nchlswhttkr/fit1041/images/buttons.jpg

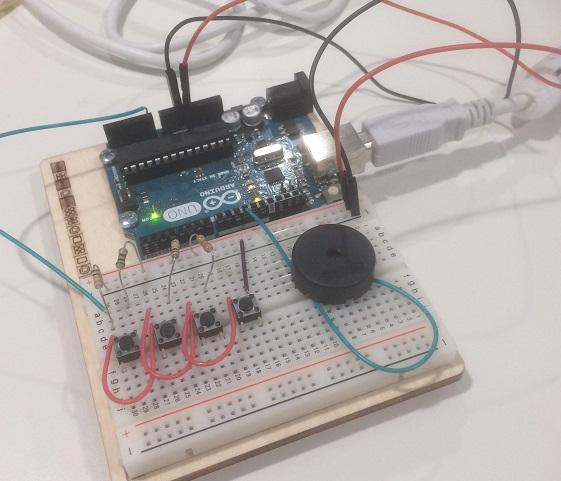
images/buttons.jpg
