nchlswhttkr/fit1041/worklog/README.MD

# Worklogs for FIT1041

[Week 2](https://github.com/NickelOz/fit1041/blob/master/worklog/WEEK2.MD)

[Week 3](https://github.com/NickelOz/fit1041/blob/master/worklog/WEEK3.MD)

[Week 4](https://github.com/NickelOz/fit1041/blob/master/worklog/WEEK4.MD)

[Week 5](https://github.com/NickelOz/fit1041/blob/master/worklog/WEEK5.MD)

[Week 6](https://github.com/NickelOz/fit1041/blob/master/worklog/WEEK6.MD)

[Week 7](https://github.com/NickelOz/fit1041/blob/master/worklog/WEEK7.MD)

[Week 8](https://github.com/NickelOz/fit1041/blob/master/worklog/WEEK8.MD)

[Week 9](https://github.com/NickelOz/fit1041/blob/master/worklog/WEEK9.MD)

[Week 10](https://github.com/NickelOz/fit1041/blob/master/worklog/WEEK10.MD)

[Week 11](https://github.com/NickelOz/fit1041/blob/master/worklog/WEEK11.MD)

[Week 12](https://github.com/NickelOz/fit1041/blob/master/worklog/WEEK12.MD)
