nchlswhttkr/fit1041/worklog/WEEK7.MD

# Week 7

This week was spent researching and placing an order on parts. A summary of the order placed and the justification can be found below.

A PDF copy of the order, as well as its justification can be found [here](https://drive.google.com/file/d/0B-P4-RA44wmtZ0tCeFZkeHNoNFE/view?usp=sharing).
